ivica3730k/si5351-wspr-transmitter/ltspice-hardware-and-measurements/driver_board_power_output_and_harmonics/10m.jpg

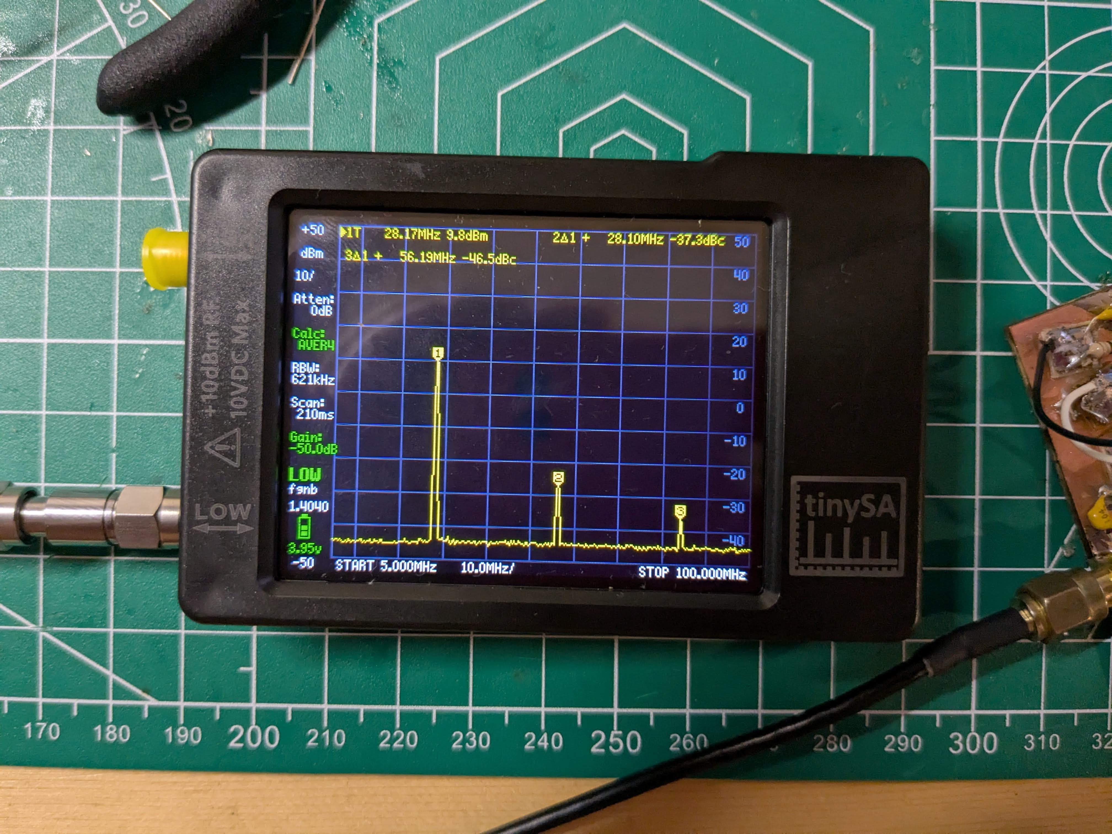
ltspice-hardware-and-measurements/driver_board_power_output_and_harmonics/10m.jpg
