ivica3730k/si5351-wspr-transmitter/ltspice-hardware-and-measurements/driver_amp_output_no_filter/20m.jpg

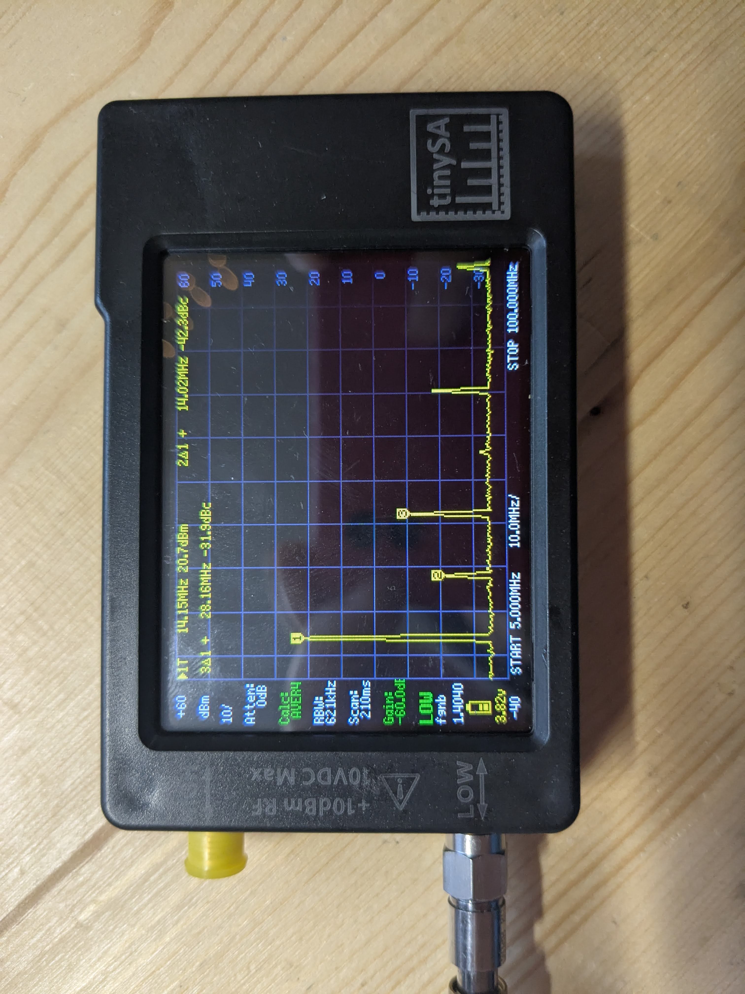
ltspice-hardware-and-measurements/driver_amp_output_no_filter/20m.jpg
