ivica3730k/si5351-wspr-transmitter/ltspice-hardware-and-measurements/pnp_npn_high_side_sw/pnp_npn_high_side_sw.asc

Q2: pnp; 2N3906
Q3: npn; 2N3904
R1: res; 1k
R2: res; 2k2
R3: res; 100r
R4: res; 1k
V1: voltage; 13.8v
V2: voltage; 5v
Named nets: vcc, 0
.tran 0 2m 1m
