ivica3730k/si5351-wspr-transmitter/ltspice-hardware-and-measurements/15m_lpf/15m_lpf.asc

C1: cap; 10n
C2: cap; 168p
C3: cap; 276p
C4: cap; 168p
C6: cap; 10n
L1: ind; 0.51µ
L2: ind; 0.51µ
R1: res; 50R
V1: voltage; SINE(0 2v 10Meg); AC 1; Rser=50
Named nets: 0
.ac lin 1000000 0.1Meg 61Meg
.NET I(R1)V1
