ivica3730k/si5351-wspr-transmitter/ltspice-hardware-and-measurements/10m_lpf/10m_lpf.asc

C1: cap; 100n
C2: cap; 120p
C3: cap; 220p
C4: cap; 120p
C6: cap; 100n
L1: ind; 0.3µ
L2: ind; 0.3µ
R1: res; 50R
V1: voltage; SINE(0 2v 10Meg); AC 1; Rser=50
Named nets: 0
.ac lin 1000000 0.1Meg 61Meg
.NET I(R1)V1
