ivica3730k/si5351-wspr-transmitter/ltspice-hardware-and-measurements/switched_20m_lpf_filter/switched_20m_lpf.asc

C1: cap; 10n
C2: cap; 220p
C3: cap; 30p
C4: cap; 220p
C5: cap; 330p
C6: cap; 10n
C7: Cap; 10p
C8: Cap; 10p
D1: diode; 1N4148
D2: diode; 1N4148
L1: ind; 0.68µ
L2: ind; 0.68µ
L3: ind; 220µ
L4: ind; 220µ
L5: ind; 220µ
R1: res; 50R
R2: Res; 33r
V1: voltage; SINE(0 2.0v 1Meg); AC 1; Rser=50
V2: Voltage; 0V; Rser=20
V3: Voltage; 3.5; Rser=20
Named nets: 0
.ac lin 1000000 0.1Meg 31Meg
.NET I(R1)V1
.tran  6u
