ivica3730k/si5351-wspr-transmitter/ltspice-hardware-and-measurements/20m_lpf/20m_lpf.asc

C1: cap; 100n
C2: cap; 220p
C3: cap; 30p
C4: cap; 220p
C5: cap; 330p
C6: cap; 100n
L1: ind; 0.68µ
L2: ind; 0.68µ
R1: res; 50R
V1: voltage; SINE(0 2v 10Meg); AC 1; Rser=50
Named nets: 0
.ac lin 1000000 0.1Meg 31Meg
.NET I(R1)V1
