ivica3730k/si5351-wspr-transmitter/ltspice-hardware-and-measurements/wspr_si5351_output_router_and_filter/wspr_si5351_output_router_and_filter.asc

C1: cap; 100n
C2: cap; 1.5n
C3: cap; 100n
C4: cap; 1µ
C5: cap; 680p
C6: cap; 1.5n
C7: cap; 10p
D1: diode; 1N4148
L1: ind; 2.87µ
L2: ind; 220µ
L3: ind; 2.87µ
R1: res; 100R
R2: res; 50R
R3: res; 100R
V1: voltage; SINE(0 2v 10Meg); AC 1; Rser=50
V2: voltage; 0v
V3: voltage; 3.3v
Named nets: 0, 3V3
.ac lin 1000000 0.1Meg 5Meg
.NET I(R2)V1
.tran 0 0.11m 0.01m
