ivica3730k/si5351-wspr-transmitter/ltspice-hardware-and-measurements/2n_3904_push_pull_amplifier/2n3904_push_pull_amplifier.asc

C1: cap; 100n
C2: cap; 47n
C3: cap; 47n
C4: cap; 100n
C5: cap; 47n
C6: cap; 47n
C7: cap; 10µ
C8: cap; 100n
L1: ind2; 17.15µ; Rser=1R
L2: ind2; 17.15µ; Rser=1R
L3: ind2; 17.15µ; Rser=1R
L4: ind2; 17.15µ; Rser=1R
L5: ind2; 17.15µ; Rser=1R
L6: ind2; 8.75µ; Rser=1R
Q1: npn; 2N3904
Q2: npn; 2N3904
R1: res; 4K7
R2: res; 330r
R3: res; 22r
R4: res; 4K7
R5: res; 22r
R6: res; 2k2
R7: res; 330r
R8: res; 22r
R9: res; 22r
R10: res; 2k2
R11: res; 50r
V1: voltage; 13.8v
V2: voltage; SINE(0 0v 14Meg); AC 100m; Rser=50
Named nets: 0, vcc
.NET I(R11)V2
.ac lin 1000 1Meg 31Meg
k2 L3 L4 L5 0.997
K1 L1 L2 L6 0.997
.tran 0 110u 100u startup
