ivica3730k/si5351-wspr-transmitter/ltspice-hardware-and-measurements/10m_lpf/10m_S11.BMP

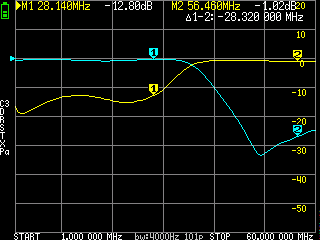
ltspice-hardware-and-measurements/10m_lpf/10m_S11.BMP
