ivica3730k/si5351-wspr-transmitter/ltspice-hardware-and-measurements/15m_lpf/15m_S11.BMP

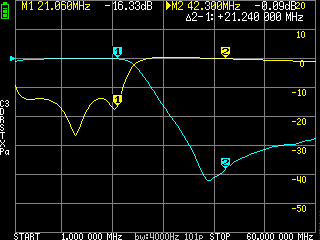
ltspice-hardware-and-measurements/15m_lpf/15m_S11.BMP
