ivica3730k/si5351-wspr-transmitter/ltspice-hardware-and-measurements/20m_lpf/20m_lpf_s11.BMP

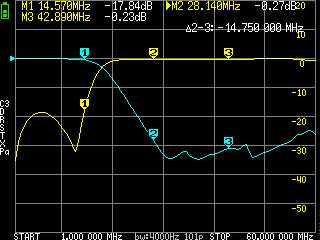
ltspice-hardware-and-measurements/20m_lpf/20m_lpf_s11.BMP
