ivica3730k/si5351-wspr-transmitter/ltspice-hardware-and-measurements/wspr_si5351_output_router_and_filter/wspr_si5351_output_router_and_filter_diode_off_s11.BMP

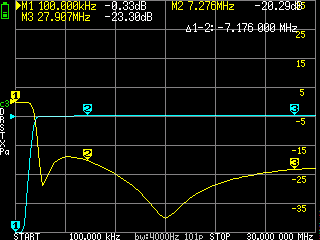
ltspice-hardware-and-measurements/wspr_si5351_output_router_and_filter/wspr_si5351_output_router_and_filter_diode_off_s11.BMP
