ivica3730k/si5351-wspr-transmitter/(commit log)

2025-05-11 added esp32 support
2025-05-11 added i2c scaner tool
2025-05-15 added switched lpf schematic
2025-05-26 add debug hardware filter flag
2025-05-26 add driver amp on_off
2025-05-26 add driver amp tinysa screenshorts
2025-08-04 add methods for setting callsign, locator and tx power,
2025-08-12 fix main cpp from not-implemented code
    [main.cpp]
